Cedev/manufacturable-ventilator/ltspice/bubble_volume_test.asc

Valph: voltage; 0.20944
Varea: voltage; 20
VBeta: voltage; PULSE(0.2 -0.3 1m 8m 1m 1)
VDplus: voltage; 1.405
X1: bubble_volume; r_max=100000
Named nets: R, 0, theta, x, arc, beta, step, alph, Varea
.tran 0.01
