Cedev/manufacturable-ventilator/ltspice/bubble_volume_min_test.asc

Bpi: bv; V=pi
Br: bi; I=if(v(r) > v(min_radius), v(bubble_area) - max(v(area), v(min_area)), v(r)+v(min_area)-max(v(area), v(min_area))- v(min_radius)); rpar=1
Valph: voltage; 0.20944
Varea: voltage; 13.9
VBeta: voltage; 0.016
VDplus: voltage; 1.405
Vr: voltage; 15.4
Xbubble_area: bubble_volume_r
Xmin_area: bubble_volume_theta
Named nets: r, theta, arc, bubble_area, x, step, alph, beta, 0, min_area, min_radius, error, area
.param epsilon=0.00001
.dc Vr -2 2 0.01
