Cedev/manufacturable-ventilator/ltspice/bubble_volume_r_test.asc

Valph: voltage; 0.20944
VBeta: voltage; 0.016
VDplus: voltage; 1.405
Vr: voltage; 13.9
X1: bubble_volume_r
Named nets: 0, R, theta, x, arc, beta, step, alph, area
.dc Vr -200 200 0.1 VBeta -.2 .2 .01
