Cedev/manufacturable-ventilator/ltspice/bubble_volume_theta_test.asc

Valph: voltage; 0.20944
VBeta: voltage; 0.016
VDplus: voltage; 1.405
Vtheta: voltage; 0.5
X1: bubble_volume_theta
Named nets: 0, R, theta, x, arc, beta, step, alph, area
.dc Vtheta 3.1415 3.1415 0.01
