Cedev/manufacturable-ventilator/ltspice/bubble_volume_x_test.asc

Valph: voltage; 0.20944
VBeta: voltage; 0.16
VDplus: voltage; 1.405
Vx: voltage; 7
X1: bubble_volume_x
Named nets: 0, R, theta, x, arc, beta, step, alph, area
.dc Vx 0 20 0.1
