Cedev/manufacturable-ventilator/ltspice/chord_test.asc

h: voltage; 1
V1: voltage; 2
X1: chord
Named nets: 0, area, r, theta
.dc h -2 6 0.01
