Cedev/manufacturable-ventilator/ltspice/bubble_volume.asc

Bpi: bv; V=pi
Br: bi; I=v(r)+if(v(r) > v(min_radius), v(bubble_area)-v(target_area), v(r)+v(min_area)-v(target_area)-v(min_radius)); rpar=1
Btarget_area: bi; I=limit(v(area), v(min_area), v(max_area)); rpar=1
Vr_max: voltage; {r_max}
X3: nc
Xbubble_area: bubble_volume_r
Xmax_area: bubble_volume_r
Xmin_area: bubble_volume_theta
Named nets: r, theta, area, arc, bubble_area, x, beta, step, alph, 0, min_area, min_radius, target_area, max_area
.param r_max=1e20
