Cedev/manufacturable-ventilator/ltspice/ventilator.asc

R1: res; R*(1-op/(sp*(1+PEEP/PIP)))
R2: res; R*op/(sp*(1+PEEP/PIP))
R3: res; R*sp/PIP
R4: res; R*(1-sp/PIP)
X1: amp_s
X2: amp_s
Named nets: supply, 0, patient, expire, inspire
sp = switching pressure of an amp (op / gain)
op = output pressure of an amp (sp * gain)
PIP = peek inspiratory pressure
PEEP = positive end expiratory pressure
