Cedev/manufacturable-ventilator/ltspice/chord.asc

BA: bi; I=0.5*v(radius)**2*(v(theta) - sin(v(theta))); rpar=1
Btheta: bi; I=2*acos(v(r)/v(radius)); rpar=1
Gr: g; 1
Rr: res; 1
Named nets: h, radius, A, r, 0, theta
