Cedev/manufacturable-ventilator/ltspice/id.asc

G1: g; 1
R1: res; 1
Named nets: x, 0, id_x
