Cedev/manufacturable-ventilator/(commit log)

2020-04-04 Ventilator master
    File for the ventilator parts used in the prototype ventilator video
2020-04-05 Base plate thickness correction
2020-04-05 Added connection plate
    Added design for connection plate and connection tapping instructions
2020-04-05 Change ventilator document size to 82mm by 82mm
2020-04-05 Background materials: The Army Emergency Respirator
2020-04-14 working with pressures, still patched
2020-04-14 circuit simulation working
2020-04-14 unpinned control currents
2020-04-14 unpinned control currents 2
2020-04-14 swapped entrained and returned flows
2020-04-16 swapped integral for capacitor, removed supports
2020-04-16 rearranged amplifier schematic
2020-04-16 vent resistance calculation (unused)
2020-04-17 vent resistance and inductance inactive
2020-04-17 simulates a switching event
2020-04-18 Use current sources for bubble volume calc
2020-04-18 switch amplifier b sources to bi2s
2020-04-20 amplifier symbol and ventilator circuit sketch
